monishram2508/analog-audio-amplifier/schematics/final.asc

C1: Cap; 6µ
C2: Cap; 470µ
C3: Cap; 10µ
C4: Cap; 100n
C5: Cap; 330p
C6: Cap; 100µ
C7: Cap; 100µ
C8: Cap; 100n
D1: diode; 1N4148
D2: diode; 1N4148
Q1: npn; BC547B
Q2: npn; BC547B
Q3: npn; BC547B
Q5: npn; Qtip31a
Q6: pnp; Qtip32a
R1: Res; 110
R2: Res; 47
R3: Res; 1.5k
R4: Res; 1.3k
R5: Res; 1.3k
R6: Res; 22k
R7: Res; 2.2k
R8: Res; 22k
R9: Res; 820
R10: Res; 820
RB1: res; 10k
RB2: res; 82k
RL1: res; 2.2k
RL2: Res; 10
U1: LM741
V1: voltage; 5
V2: Voltage; -5
V3: Voltage; SINE(0 0.01 1k); AC 1
V5: Voltage; 12
V6: Voltage; -12
V7: Voltage; 5
V8: Voltage; -5
Named nets: 0, VE, OUT
.include tip31a.lib
.include tip32a.lib
.tran 10m
.ac dec 10 1 100k
.four 1k 20 10 V(OUT)
.op
