monishram2508/analog-audio-amplifier/schematics/poweramp copy.asc

C1: Cap; 100µ
C2: Cap; 100µ
D1: diode; 1N914
D2: diode; 1N914
Q1: npn; Qtip31a
Q2: pnp; Qtip32a
R1: Res; 150
R2: Res; 150
R3: Res; 100
RL: Res; 10
V1: Voltage; 5
V2: Voltage; -5
V3: Voltage; SINE(0 4 1k)
Named nets: 0
.include tip31a.lib
.include tip32a.lib
.tran 10m
.op
