monishram2508/analog-audio-amplifier/schematics/pre-amp+gain.asc

C2: cap; 10n
C3: Cap; 100µ
C4: Cap; 10µ
Q1: npn; BC547B
Q2: npn; BC547B
Q3: npn; BC547B
R1: Res; 2.2k
R2: Res; 1k
R3: Res; 1k
R5: Res; 100
R7: Res; 47
RB1: res; 10k
RB2: res; 82k
RL1: res; 1.8k
V1: Voltage; SINE(0 0.01 10k 0 0 180)
V2: Voltage; SINE(0 0.01 10k)
V4: voltage; 5
V5: Voltage; -5
Named nets: 0, VE
.tran 1m
.op
